jodalyst/ADP5350/prototype_fab_6/joe1/BOM_v2.xls

BOM/PCBA quantity (Required) |  | 10
PCB/Project Name (Required) |  | PowerBoard V1.0
Part Identification |  |  |  |  |  |  |  |  | Customer Information |  | Quantity
# | Part ID / Reference (Required) | Manufacturer | Part Number (Required) | Description | Value (Required) | Package (Required) | THT (y/n) | Pins / Pads Qty | Source/Link/ Datasheet/Note | Source / Target Price | Quantity per BOM (Required)
1 | U1 | Analog Devices | ADP5350 | IC PWR MGMT LI-ION 32LFCSP | 7.806 | 32-LFCSP | n | 33 | ADP5350ACPZ-1-R7CT-ND | digikey/7.806 | 1
2 | L1 | TDK Corporation | VLS201612CX-1R5M-1 | FIXED IND 1.5UH 1.9A 89 MOHM SMD | 1.5 uH | 0805 | n | 2 | 445-172961-1-ND | digikey/0.396 | 1
3 | C9, C8 | TDK Corporation | C2012X7R1C225K125AB | CAP CER 2.2UF 16V X7R 0805 | 2.2 uF | 0805 | n | 2 | 445-1420-1-ND | digikey/0.132 | 2
4 | C4,C6 | TDK Corporation | C2012X5R1C106K085AC | CAP CER 10UF 16V X5R 0805 | 10 uF | 0805 | n | 2 | 445-7644-1-ND | digikey/0.169 | 2
5 | C1,C3,C2,C7 | TDK Corporation | C2012X8R1C105K125AB | CAP CER 1UF 16V X8R 0805 | 1 uF | 0805 | n | 2 | 445-8829-1-ND | digikey/0.31 | 4
6 | C5 | TDK Corporation | C2012X7R1A475M125AC | CAP CER 4.7UF 10V X7R 0805 | 4.7 uF | 0805 | n | 2 | 445-1605-1-ND | digikey/0.19 | 1
7 | R2, R3, R4 | Susumu | RL1220S-R50-F | RES 0.5 OHM 1% 1/3W 0805 | 0.5 Ohm | 0805 | n | 2 | RL12S.50FCT-ND | digikey/0.267 | 3
8 | R5, R6, R10, R11, R12 | Yageo | RC0805FR-074K7L | RES SMD 4.7K OHM 1% 1/8W 0805 | 4.7 Kohm | 0805 | n | 2 | 311-4.70KCRCT-ND | digikey/0.022 | 5
9 | R1 | Yageo | RC0805FR-0747KL | RES SMD 47K OHM 1% 1/8W 0805 | 47 kOhm | 0805 | n | 2 | 311-47.0KCRCT-ND | digikey/0.022 | 1
10 | D1, D2, D3 | Lumex | SML-LXR85GC-TR | LED GREEN CLEAR 2SMD R/A | green | 0805 | n | 2 | 67-1557-1-ND | digikey/0.33 | 3
 | R7, R8, R9 | Yageo | RC0805FR-072K2L | RES SMD 2.2K OHM 1% 1/8W 0805 | 2.2 Kohm | 0805 | n | 2 | 311-2.20KCRTR-ND | digikey/0.00284 | 3
