jodalyst/ADP5350/(list of files, drawings)

Other design files:
prototype_fab_6/joe1/joe1.dsn
