jodalyst/ADP5350/prototype_fab_6/joe1/joe1.kicad_pcb

## KiCad design prototype_fab_6/joe1/joe1.kicad_pcb (2018-01-12)

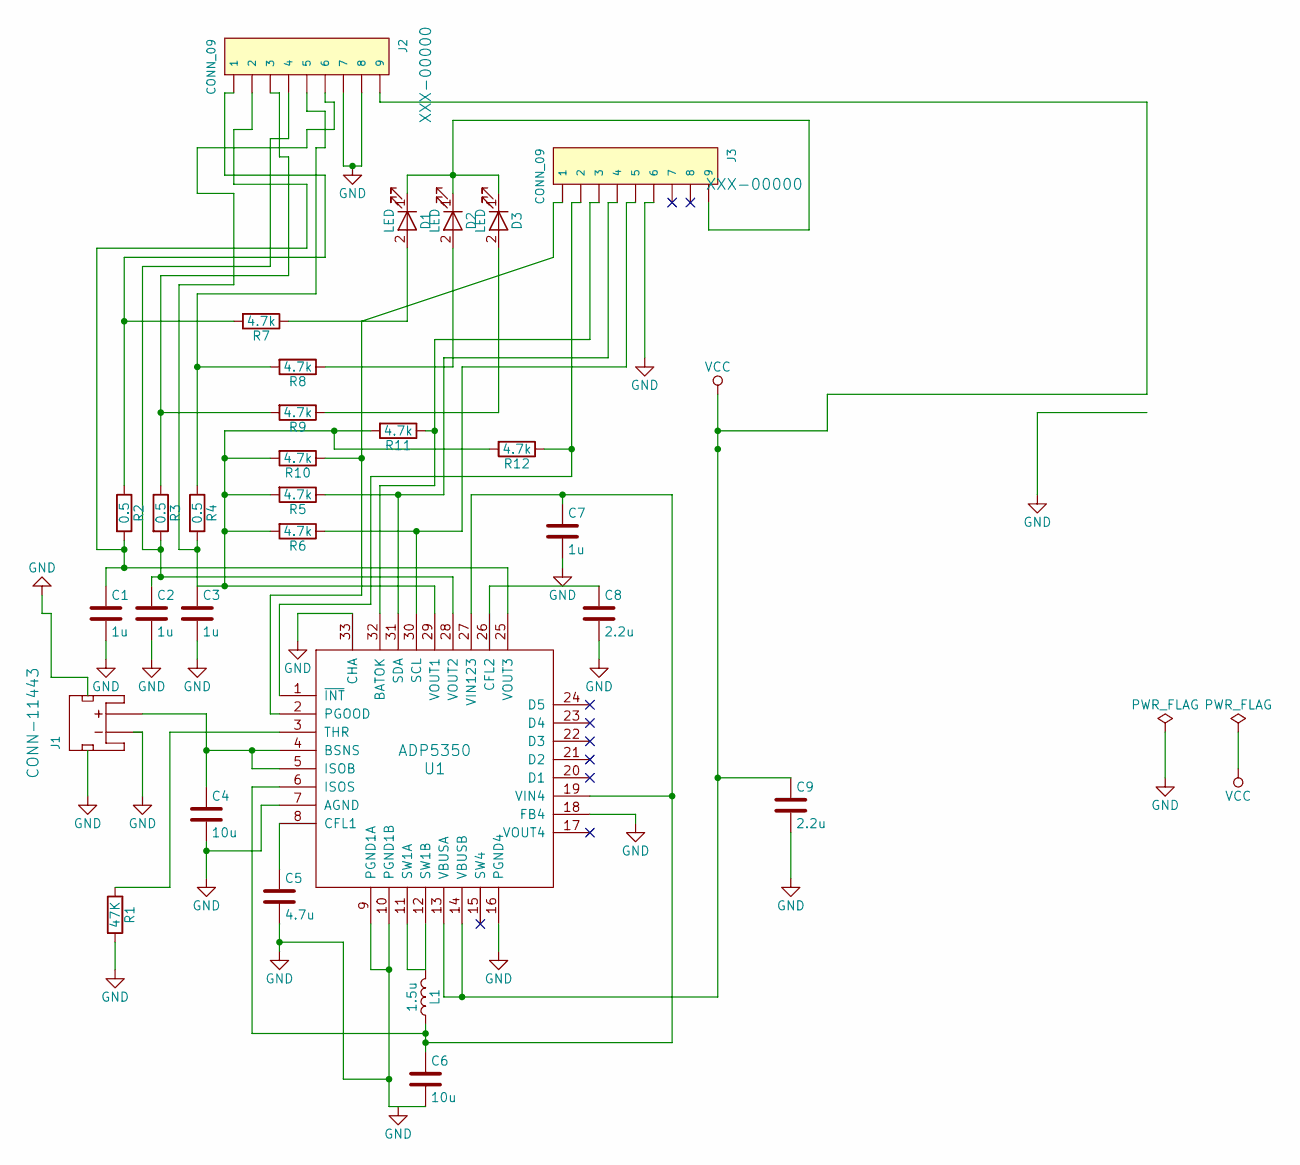
[picture p1: schematic joe1.sch, test1]

Parts:
C1, C2, C3, C7: 1u; C_0805_HandSoldering
C4, C6: 10u; C_0805_HandSoldering
C5: 4.7u; C_0805_HandSoldering
C8, C9: 2.2u; C_0805_HandSoldering
D1, D2, D3: LED; LED_0805_HandSoldering
J1: JST_2MM_MALE; JST-2-PTH
J2, J3: CONN_09; 1X09
L1: 1.5u; L_0805_HandSoldering
R1: 47K; R_0805_HandSoldering
R2, R3, R4: 0.5; R_0805_HandSoldering
R5, R6, R7, R8, R9, R10, R11, R12: 4.7k; R_0805_HandSoldering
U1: ADP5350; QFN-32-1EP_5x5mm_Pitch0.5mm

Connections:
GND: C1.2, C2.2, C3.2, C4.2, C5.2, C6.2, C7.2, C8.2, C9.2, J1.1 (-), J1.NC1 (PAD1), J1.NC2 (PAD2), J2.7, J2.8, J3.6, R1.2, U1.7 (AGND), U1.9 (PGND1A), U1.10 (PGND1B), U1.16 (PGND4), U1.18 (FB4), U1.33 (CHA)
unnamed: C1.1, J2.2, R2.2, U1.25 (VOUT3)
unnamed: C2.1, J2.4, R3.2, U1.28 (VOUT2)
unnamed: C3.1, J2.6, R4.2, R5.2, R6.2, R10.2, R11.2, R12.2, U1.29 (VOUT1)
unnamed: C4.1, J1.2 (+), U1.4 (BSNS), U1.5 (ISOB)
unnamed: C5.1, U1.8 (CFL1)
unnamed: C6.1, C7.1, L1.1, U1.6 (ISOS), U1.19 (VIN4), U1.27 (VIN123)
unnamed: C8.1, U1.26 (CFL2)
unnamed: D1.1 (K), D2.1 (K), D3.1 (K), J3.9
unnamed: D1.2 (A), R7.1
unnamed: D2.2 (A), R8.1
unnamed: D3.2 (A), R9.1
unnamed: J2.1, R2.1, R7.2
unnamed: J2.3, R3.1, R9.2
unnamed: J2.5, R4.1, R8.2
unnamed: J3.1, R10.1, U1.2 (PGOOD)
unnamed: J3.2, R12.1, U1.1 (~INT)
unnamed: J3.3, R11.1, U1.32 (BATOK)
unnamed: J3.4, R5.1, U1.31 (SDA)
unnamed: J3.5, R6.1, U1.30 (SCL)
unnamed: L1.2, U1.11 (SW1A), U1.12 (SW1B)
unnamed: R1.1, U1.3 (THR)
VCC: C9.1, J2.9, U1.13 (VBUSA), U1.14 (VBUSB)

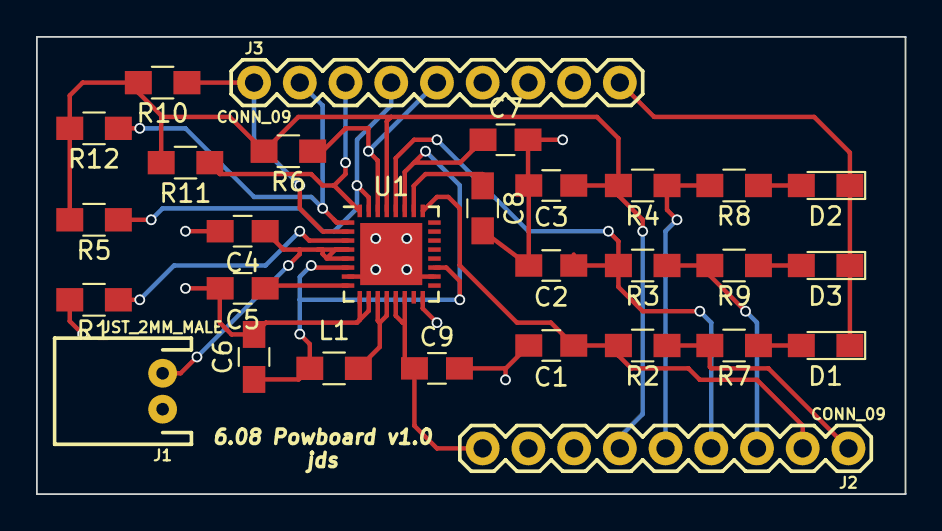
[picture p2: board prototype_fab_6/joe1/joe1.kicad_pcb from above]

Board: 2 copper layers, 48.3 x 25.4 mm, 29 parts (0 on the bottom side), 23 nets.
