jodalyst/ADP5350/prototype_fab_3/joe1/joe1.kicad_pcb

## KiCad design prototype_fab_3/joe1/joe1.kicad_pcb (2017-12-14, an earlier design)

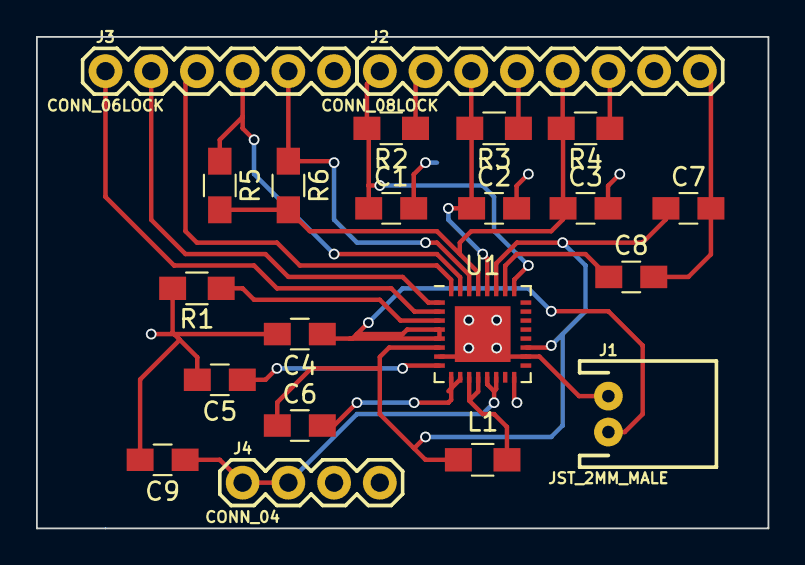
[picture p3: board prototype_fab_3/joe1/joe1.kicad_pcb from above]

Board: 2 copper layers, 40.6 x 27.3 mm, 21 parts (0 on the bottom side), 20 nets.

Parts:
C1, C2, C3, C7: 1u; C_0805_HandSoldering
C4, C6: 10u; C_0805_HandSoldering
C5: 4.7u; C_0805_HandSoldering
C8, C9: 2.2u; C_0805_HandSoldering
J1: JST_2MM_MALE; JST-2-PTH
J2: CONN_08LOCK; 1X08
J3: CONN_06LOCK; 1X06
J4: CONN_04; 1X04
L1: 1.5u; L_0805_HandSoldering
R1: 47K; R_0805_HandSoldering
R2, R3, R4: 0.5; R_0805_HandSoldering
R5, R6: 4.7k; R_0805_HandSoldering
U1: ADP5350; WQFN-32-1EP_5x5mm_Pitch0.5mm

Connections:
GND: C1.2, C2.2, C3.2, C4.2, C5.2, C7.2, C8.2, C9.2, J1.1, J2.7, J2.8, J3.6, J4.3, J4.4, R1.2, U1.7, U1.16, U1.18, U1.33
unnamed: C1.1, J2.1, R2.2, U1.25
unnamed: C2.1, J2.3, R3.2, U1.28
unnamed: C3.1, J2.5, R4.2, R5.2, R6.2, U1.29
unnamed: C4.1, J1.2, U1.4, U1.5
unnamed: C5.1, U1.8
unnamed: C6.1, C7.1, L1.1, U1.6, U1.19, U1.27
unnamed: C6.2, U1.9, U1.10
unnamed: C8.1, U1.26
unnamed: J2.2, R2.1
unnamed: J2.4, R3.1
unnamed: J2.6, R4.1
unnamed: J3.1, U1.2
unnamed: J3.2, U1.1
unnamed: J3.3, U1.32
unnamed: J3.4, R5.1, U1.31
unnamed: J3.5, R6.1, U1.30
unnamed: L1.2, U1.11, U1.12
unnamed: R1.1, U1.3
VCC: C9.1, J4.1, J4.2, U1.13, U1.14
