jodalyst/ADP5350/(commit log)

2017-09-26 updating batter ldo control...still wrong
    [adp5350.h, ap5350.cpp]
2017-10-09 Just a few declaration errors that were corrected. The example code is completely functional.
    [adp5350.h, adp5350_example.ino, ap5350.cpp]
2017-10-25 Fixed small bug(s) regarding LDO control. Added functionality to control the voltage output of LDOs.
    [adp5350.h, adp5350_example.ino, ap5350.cpp]
2017-11-03 Added the KiCad devboard for the ADP5350
    LDOs 1-3 have the voltage divider circuit. Didn't remember which resistor values to use so I just said 40K for the dividing and 1 Ohm for the current sense
    Could not find anything appropriate to create the switches so left them blank for the time being
    Have not started the physical board layout yet
    [adp5350_devboard.kicad_pcb, adp5350_devboard.sch]
2017-11-06 Replaced switches with wires and changed resistor values to 10K Ohms
2017-11-08 Mapped schematic parts to footprints for PCB. Size of L/R/C footprints -> 1206
    Simplified some circuitry for the sake of sizing and uneeded parts.
    Changed test points out with individual parts.
    2 errors in electrical rules/connectivity testing ignored (not important)
    [_saved_adp5350_devboard.sch]
2017-12-03 moving files and updating test file
    [_saved_adp5350_devboard.sch, adp5350_devboard.kicad_pcb, adp5350_devboard.sch]
2017-12-04 adding in kicad stuff for testing/prototyping
    [joe1.dsn, joe1.kicad_pcb, joe1.sch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]
2017-12-05 new files for fab submissionl
    [joe1-B.Cu.gbl, joe1-B.Mask.gbs, joe1-B.SilkS.gbo, joe1-Edge.Cuts.gm1, joe1-F.Cu.gtl, joe1-F.Mask.gts, joe1-F.SilkS.gto, joe1.drl]
2017-12-14 adding in new fab and update library
    [joe1-B.Cu.gbl, joe1-B.Mask.gbs, joe1-B.SilkS.gbo, joe1-Edge.Cuts.gm1, joe1-F.Cu.gtl, joe1-F.Mask.gts, joe1-F.SilkS.gto, joe1.drl]
2017-12-18 adding in new design layer
    [BOM_order.xls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]
2017-12-22 redoing library with pin 33
2018-01-10 adding in minor changes for ESP32 compatibility
    [BOM_order.xls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]
2018-01-10 adding in battery tracking example
2018-01-12 adding in the newest version of hte ADPboard, with BOM, etc...) .
    [BOM_order copy.xls, BOM_order.xls, BOM_v2.xls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]
